githupsuser/SOS/HW/Common/ICS-40300.step

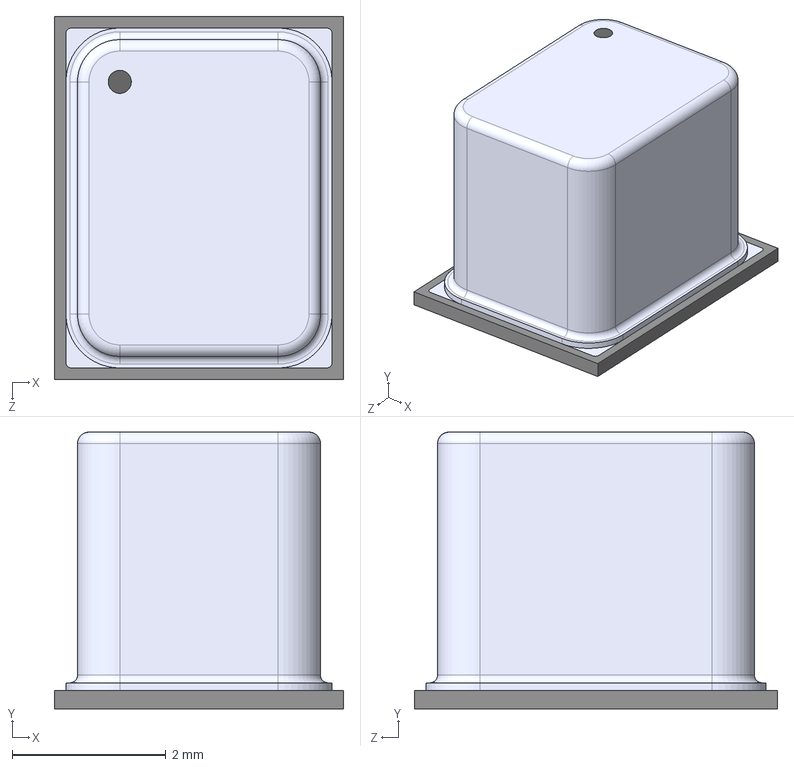
[picture p8: CAD file, 2024-11-08]
HW/Common/ICS-40300.step
3.76 x 3.60 x 4.72 mm
