githupsuser/SOS/HW/Common/STP_74930000 (rev1).stp

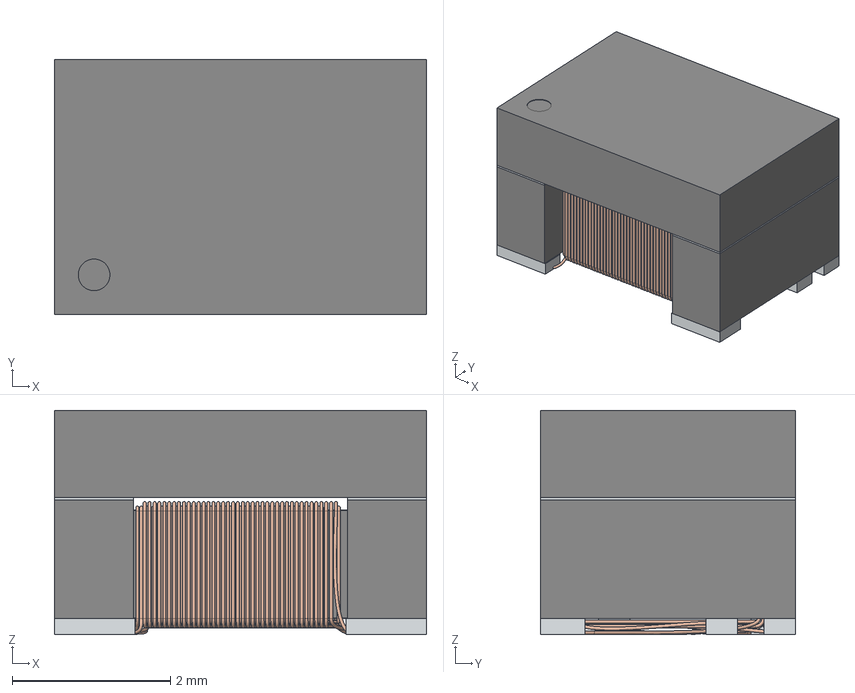
[picture p9: CAD file, 2024-11-08]
HW/Common/STP_74930000 (rev1).stp
4.70 x 3.22 x 2.83 mm
Core
Windings_02
Pins
Glue
Upper Plate
