githupsuser/SOS/HW/Main/SOS_Main.pdf

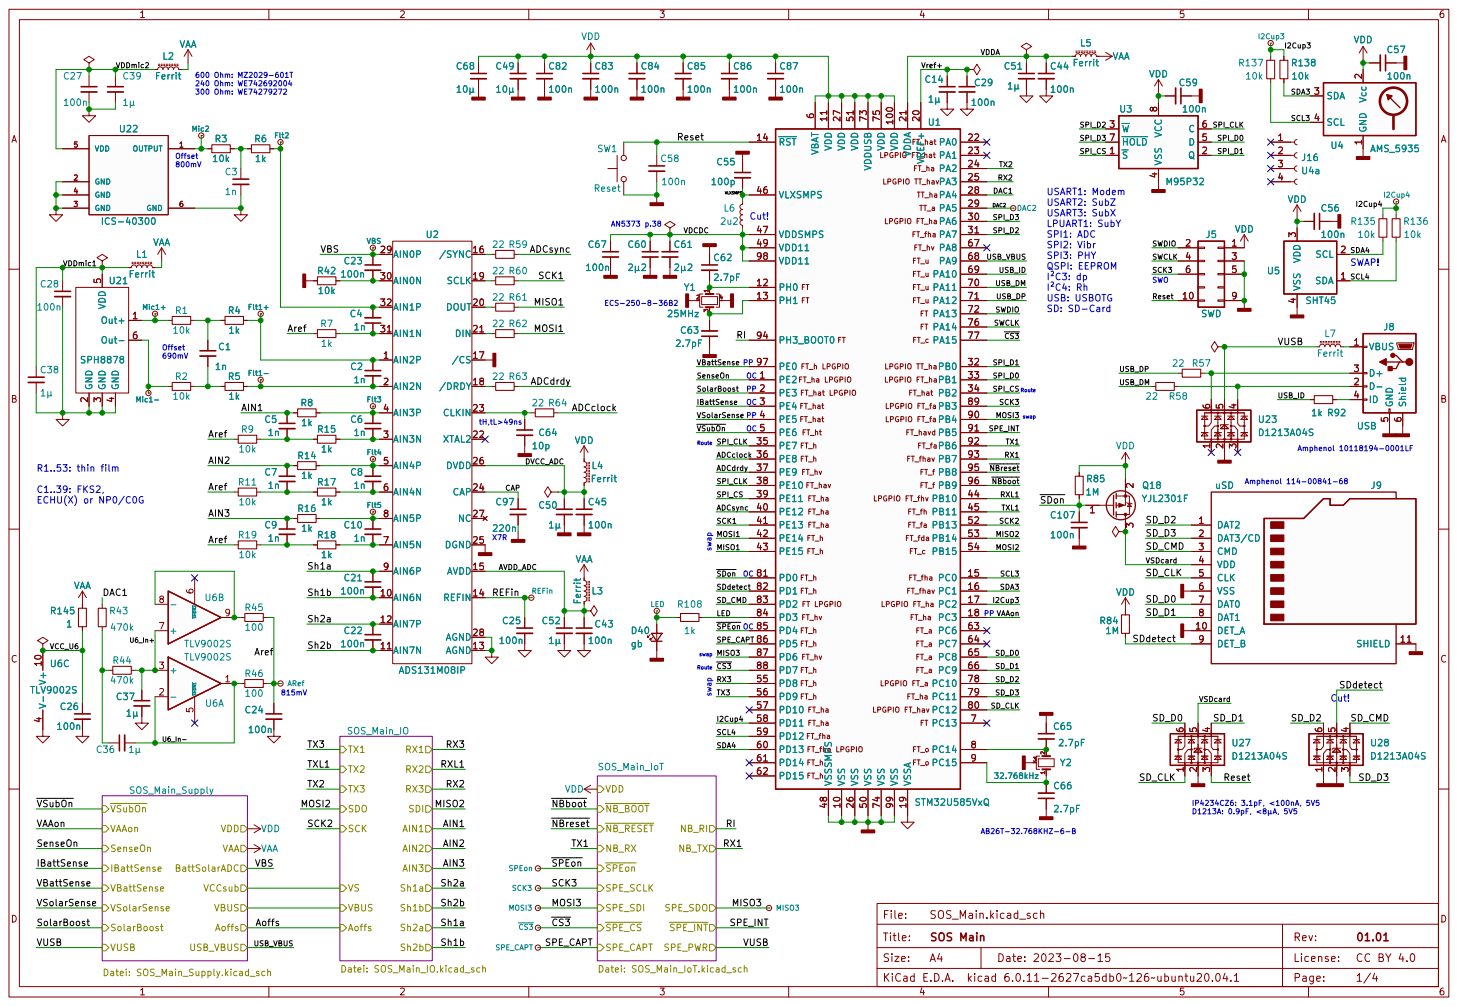
[picture p10: page 1]

1 Vcc 2 SDA 3 SCL 4 U4 AMS_5935 VDD

LPUART1: SubY
SPI1: ADC
SPI2: Vibr SPI3: PHY QSPI: EEPROM

þÿI²C4: Rh USB: USBOTG

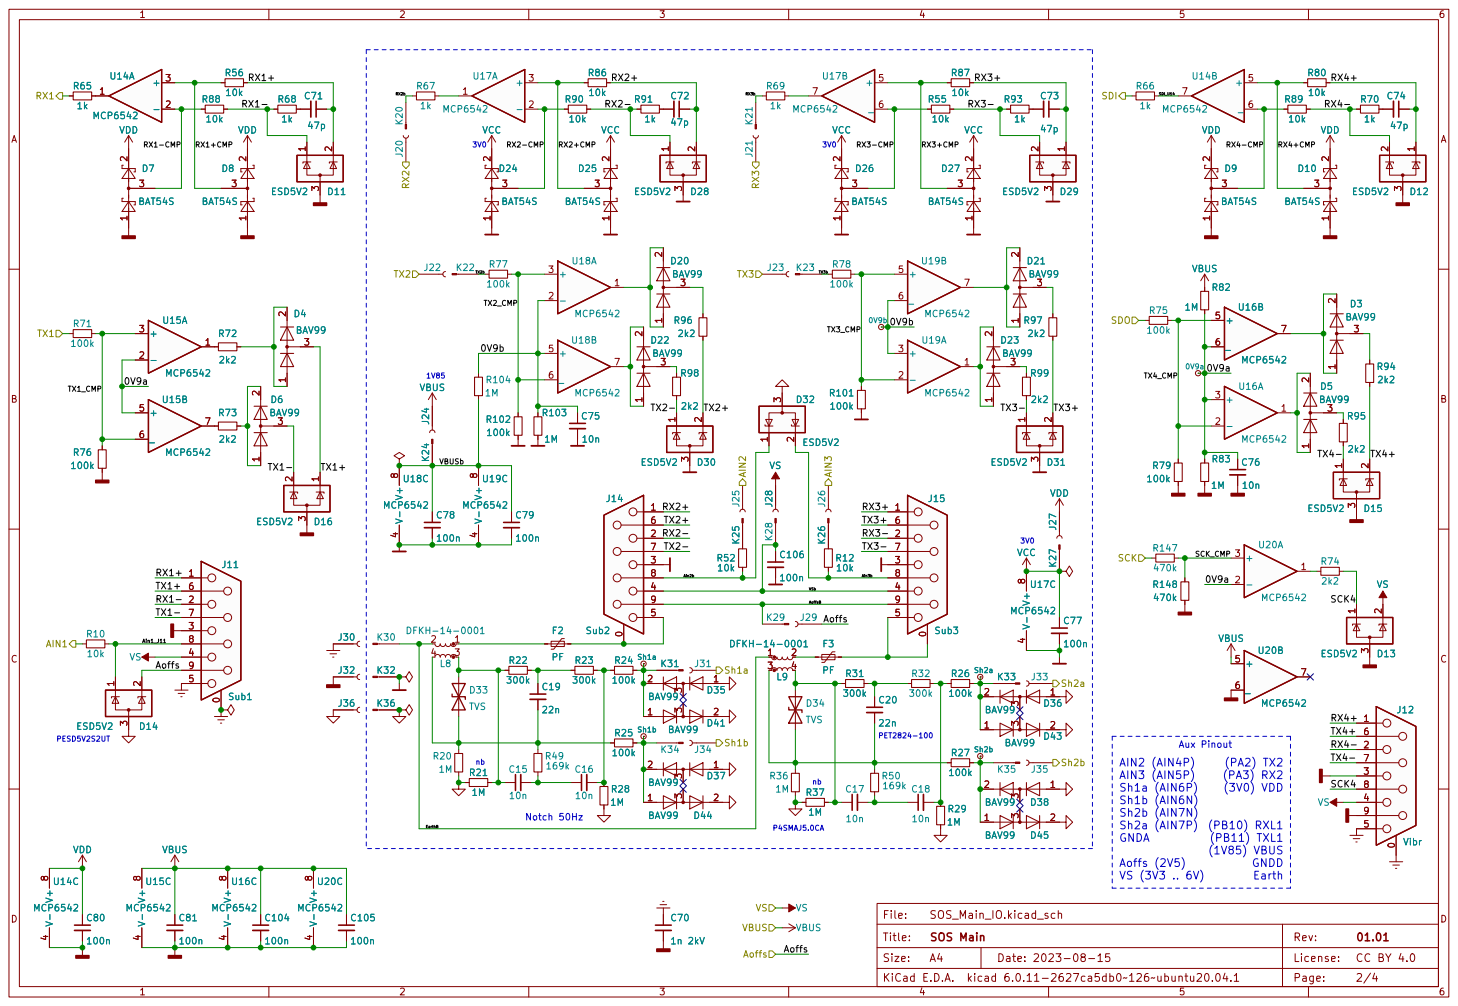
[picture p11: page 2]

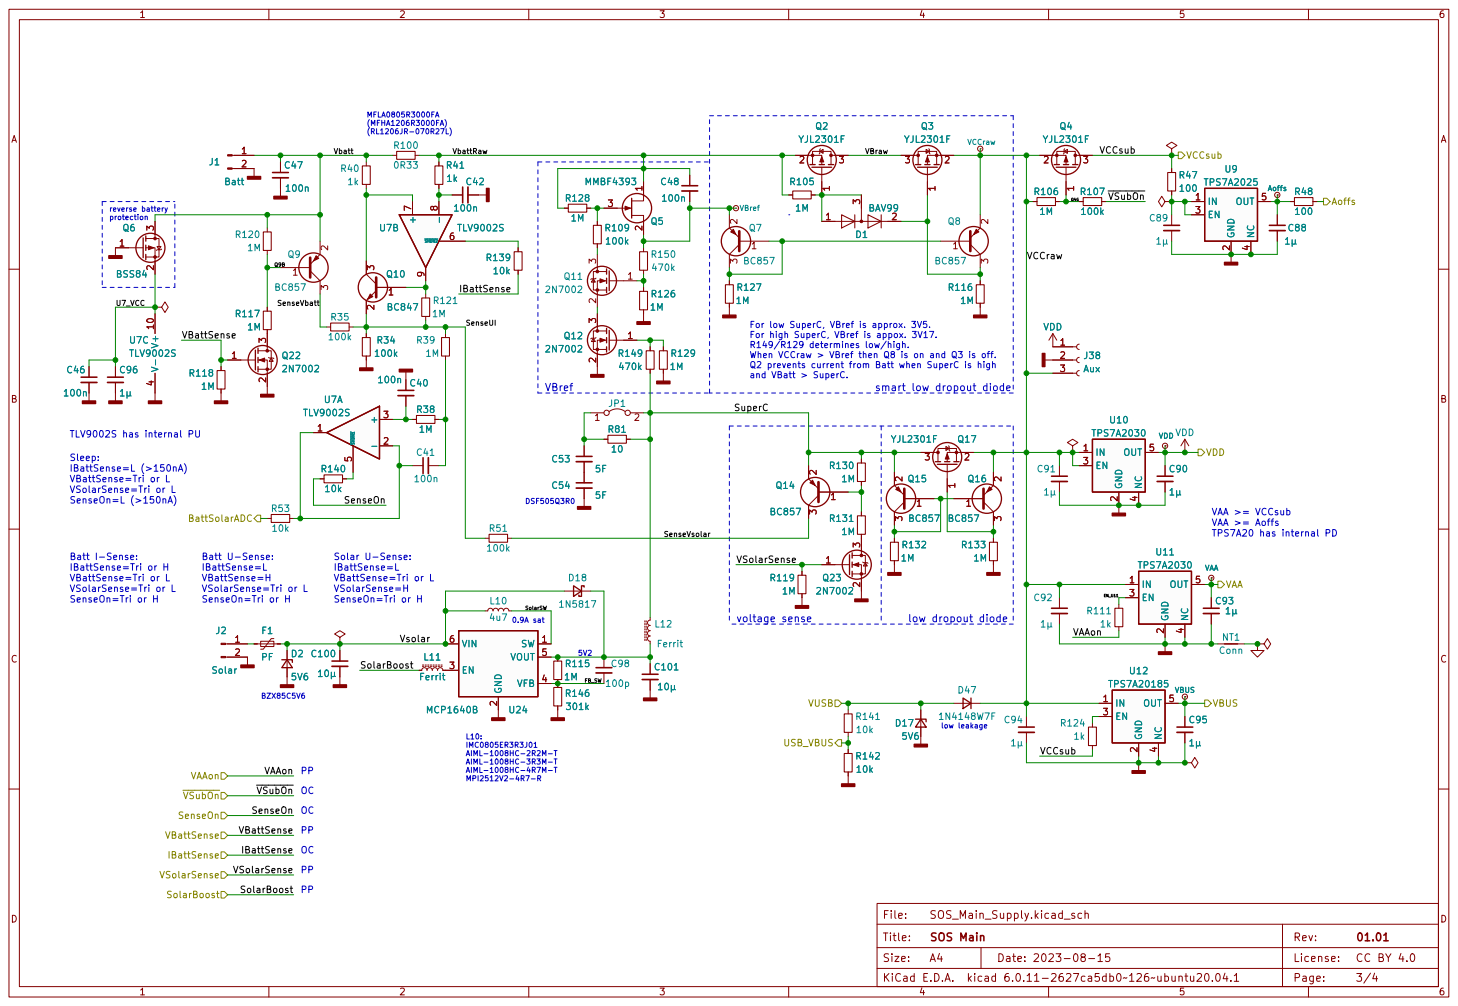
[picture p12: page 3]

SolarSW Vsolar SolarBoost VBattSense

voltage sense Batt I-Sense:

IBattSense VBattSense VAAon
SolarBoost VSolarSense SenseOn ~{VSubOn}

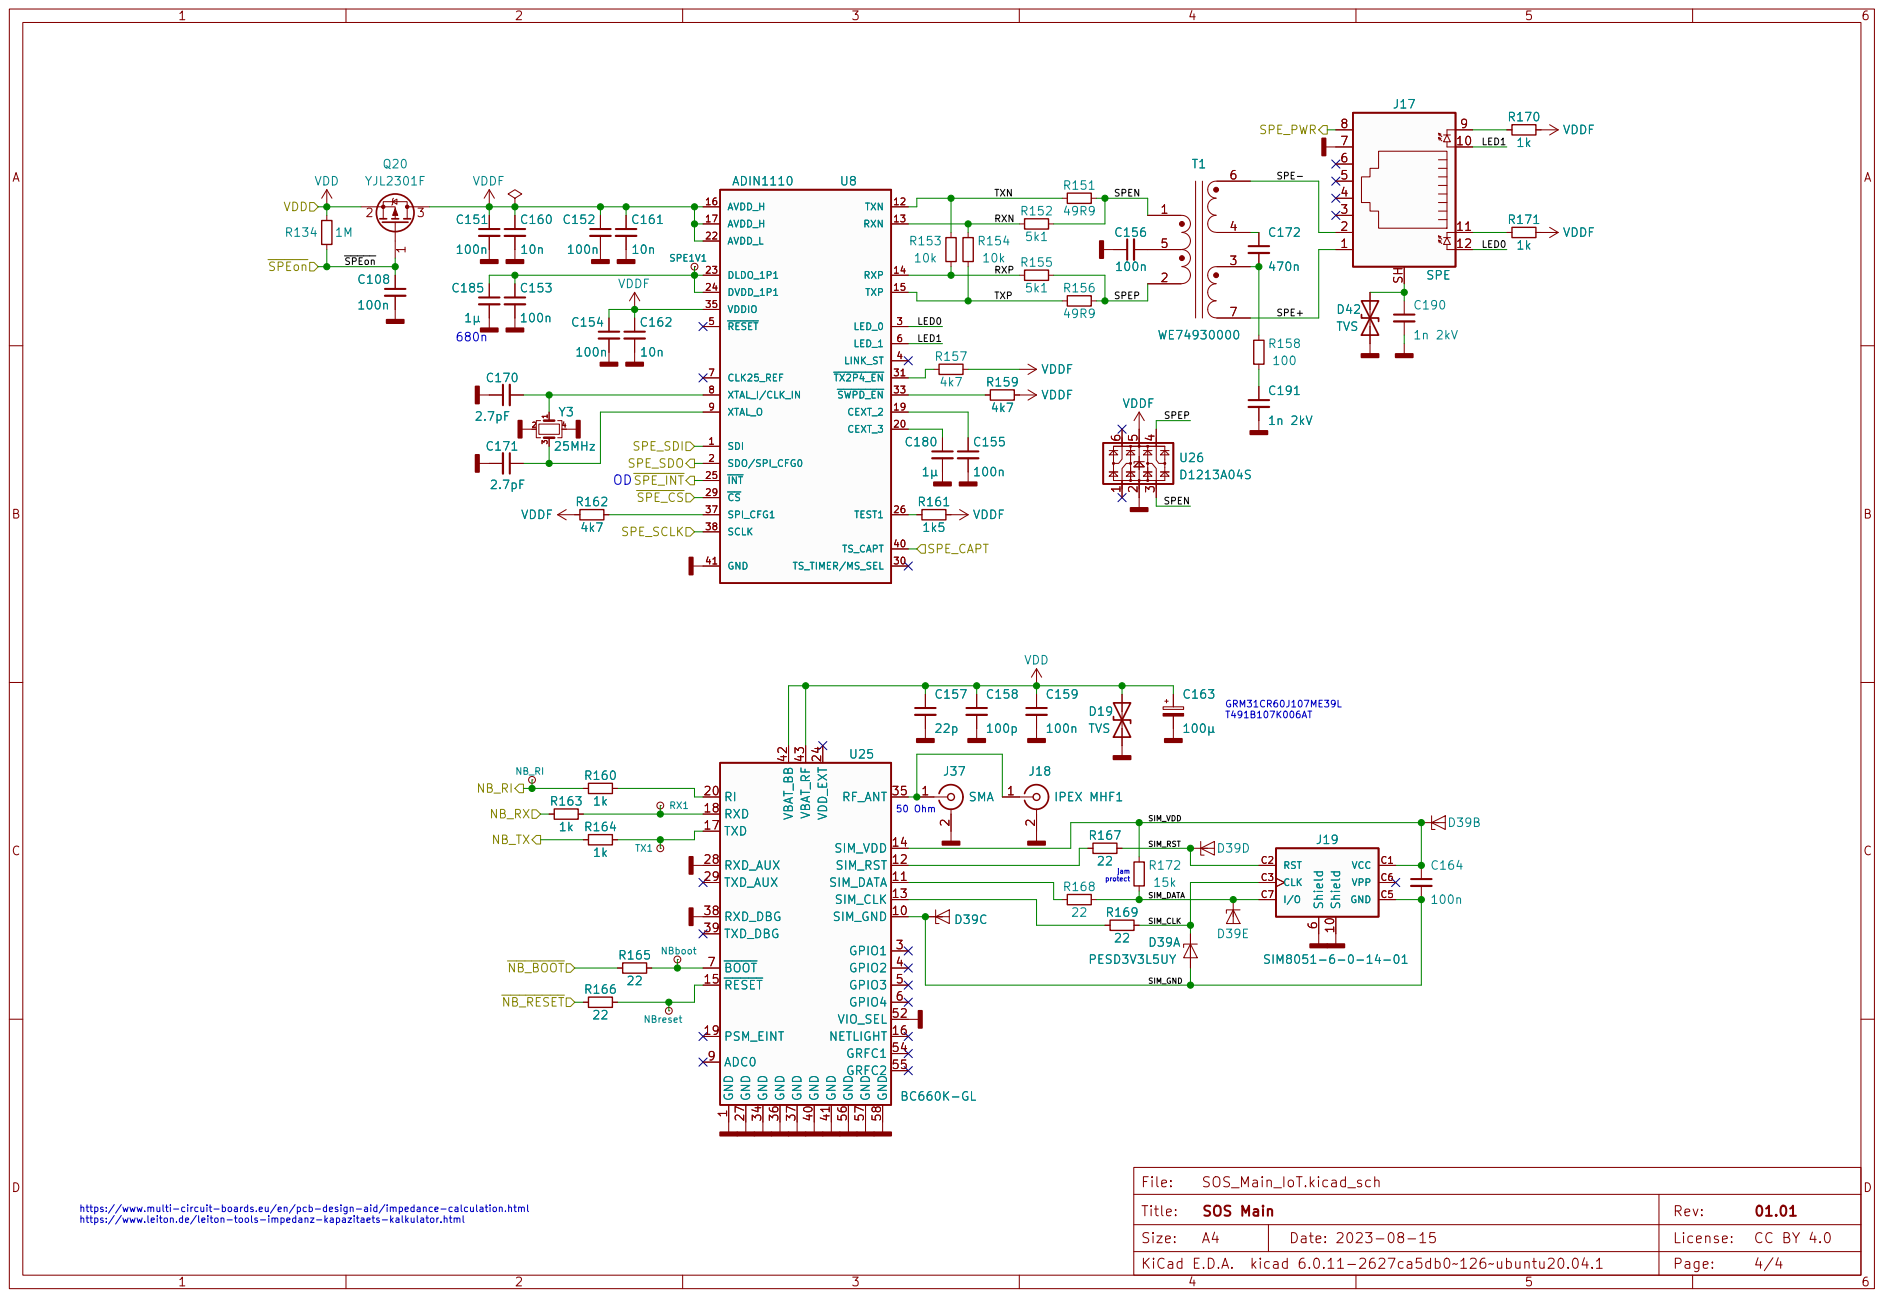
[picture p13: page 4]

https://www.multi-circuit-boards.eu/en/pcb-design-aid/impedance-calculation.html https://www.leiton.de/leiton-tools-impedanz-kapazitaets-kalkulator.html
