githupsuser/SOS/HW/Mic/SOS_Mic.pdf

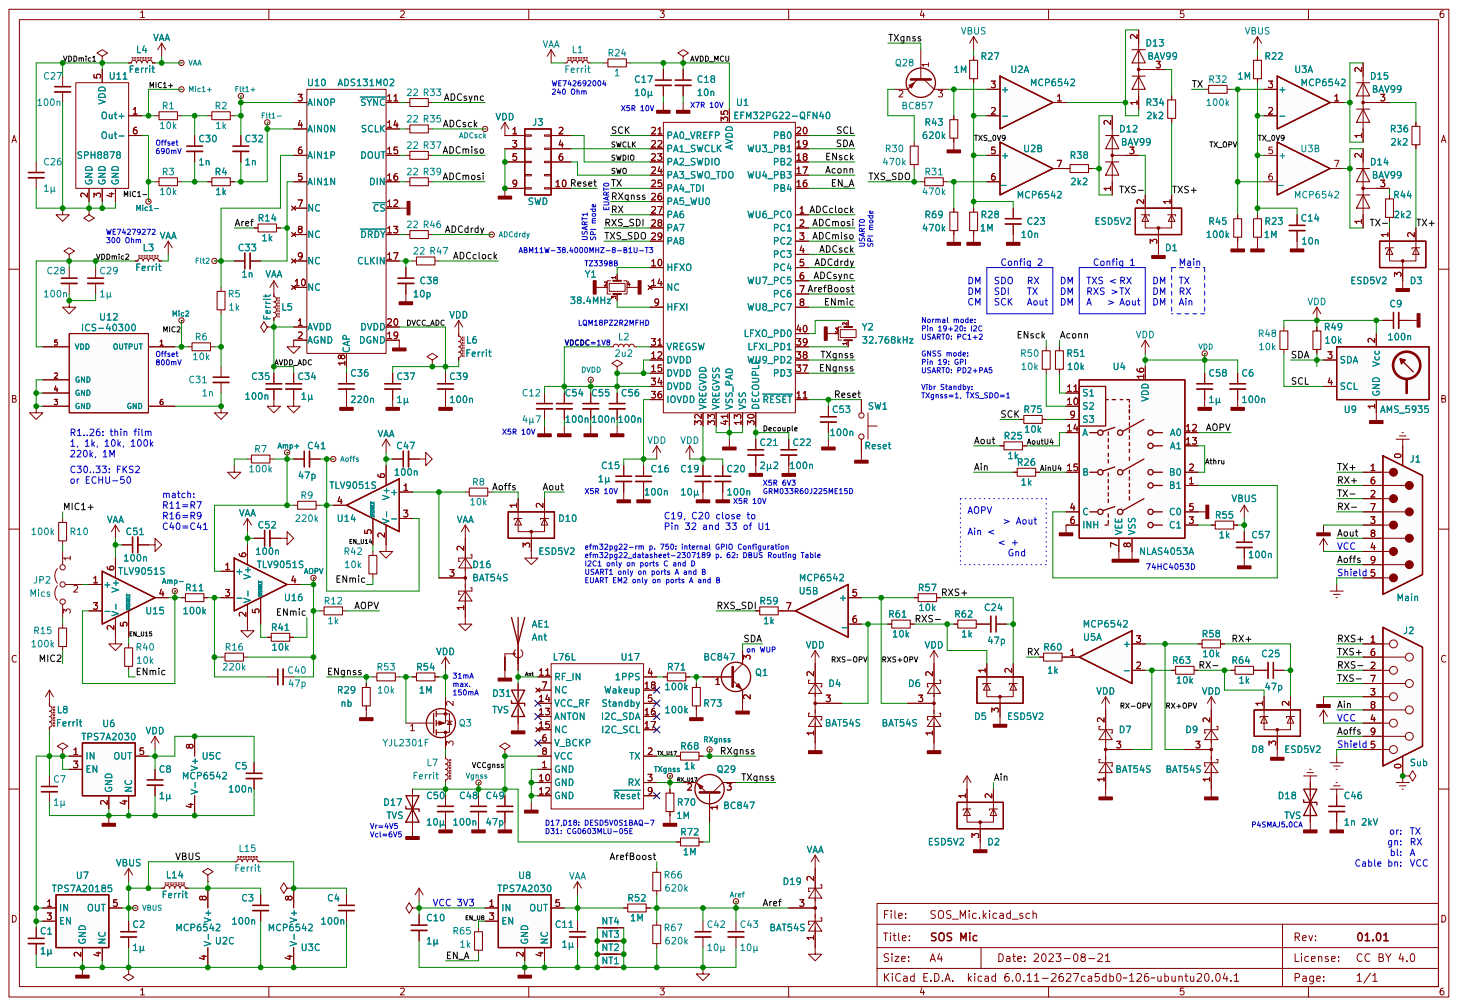
[picture p14: page 1]

I2C1 only on ports C and D
USART1 only on ports A and B

or: gn: bl: Cable bn:
