githupsuser/SOS/HW/Vibr/SOS_Vibr.pdf

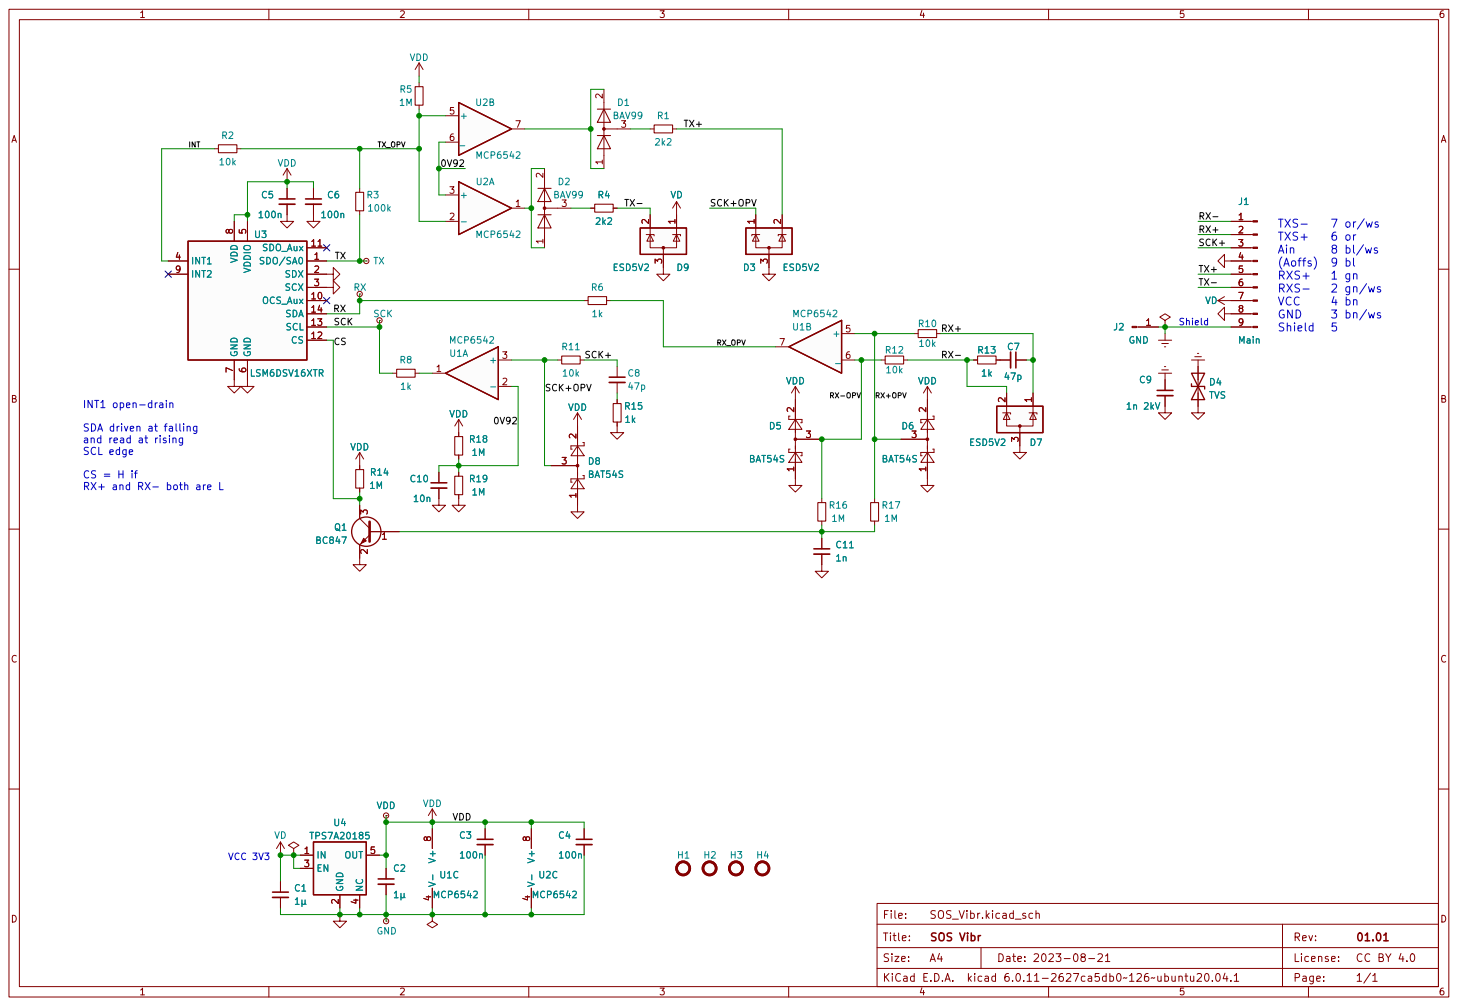
[picture p15: page 1]

INT1 open-drain SDA driven at falling
