githupsuser/SOS/HW/Vibr/SOS_Vibr.kicad_pcb

## KiCad design HW/Vibr/SOS_Vibr.kicad_pcb (2024-11-08)

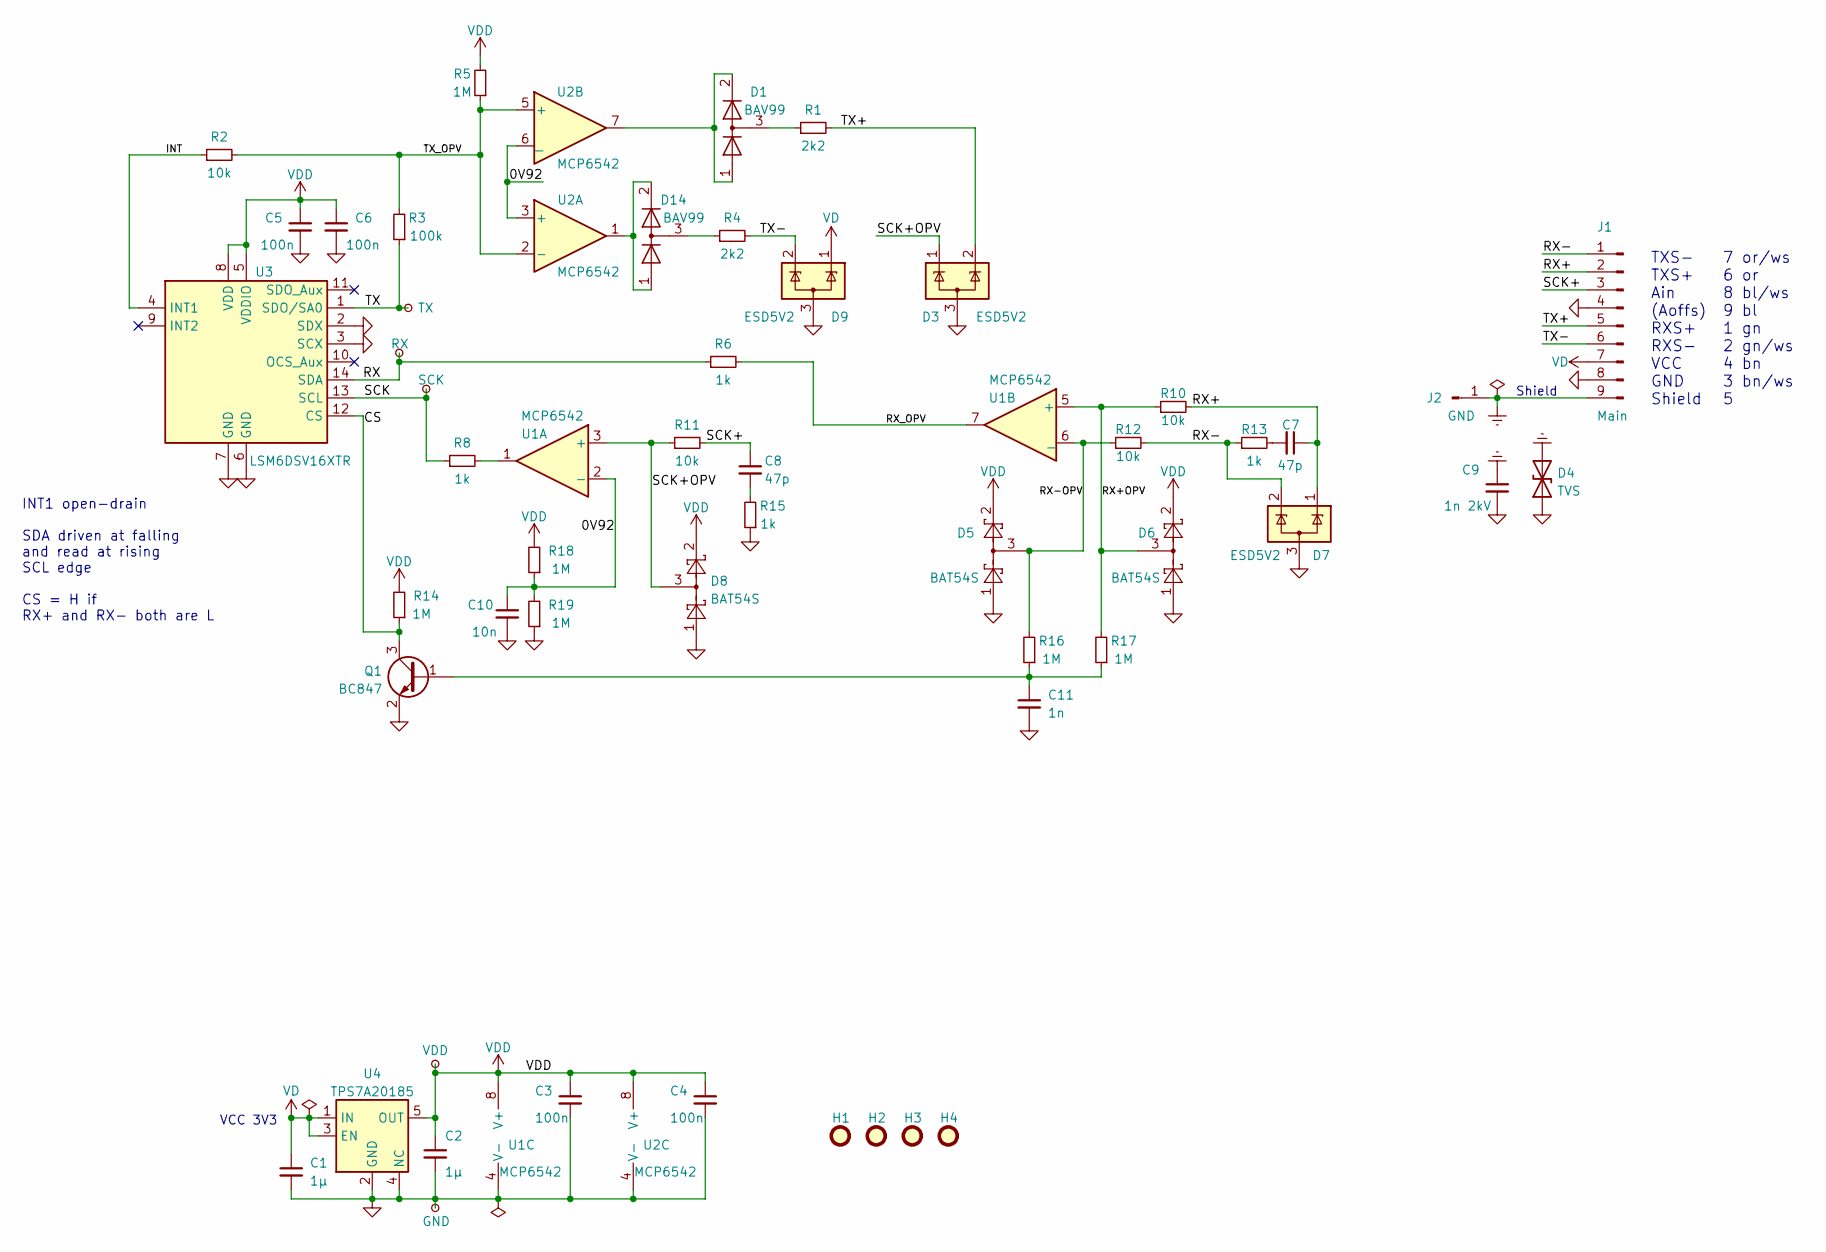
[picture p16: schematic SOS_Vibr.kicad_sch, SOS Vibr]

Parts:
C1, C2: 1µ; C_0805_2012Metric
C3, C4, C5, C6: 100n; C_0603_1608Metric
C7, C8: 47p; C_0603_1608Metric
C9: 1n 2kV; C_1206_3216Metric
C10: 10n; C_0603_1608Metric
C11: 1n; C_0603_1608Metric
D1, D14: BAV99; SOT-23
D3, D7, D9: ESD5V2; SOT-23
D4: TVS; D_SMA
D5, D6, D8: BAT54S; SOT-23
H1, H2, H3, H4: MountingHole; MountingHole_2.7mm_M2.5
J1: Main; PinHeader_1x09_P2.54mm_Vertical
J2: GND; SolderWire-0.75sqmm_1x01_D1.25mm_OD2.3mm
Q1: BC847; SOT-23
R1, R4: 2k2; R_0603_1608Metric
R2, R10, R11, R12: 10k; R_0603_1608Metric
R3: 100k; R_0603_1608Metric
R5, R14, R16, R17, R18, R19: 1M; R_0805_2012Metric
R6, R8, R13, R15: 1k; R_0603_1608Metric
TP1: VDD; TestPoint_THTPad_D1.0mm_Drill0.6mm
TP2: TX; TestPoint_THTPad_D1.0mm_Drill0.6mm
TP3: RX; TestPoint_THTPad_D1.0mm_Drill0.6mm
TP4: SCK; TestPoint_THTPad_D1.0mm_Drill0.6mm
TP5: GND; TestPoint_THTPad_D1.0mm_Drill0.6mm
U1, U2: MCP6542; SOIC-8_3.9x4.9mm_P1.27mm
U3: LSM6DSV16XTR; LGA-14_3x2.5mm_P0.5mm_LayoutBorder3x4y
U4: TPS7A20185; SOT-23-5

Connections:
/0V92: C10.1, R18.1, R19.2, U1.2 (-), U2.3 (+), U2.6 (_)
/CS: Q1.3 (C), R14.1, U3.12 (CS)
/INT: R2.1, U3.4 (INT1)
/RX: R6.1, TP3.1, U3.14 (SDA)
/RX+: C7.1, D7.1 (K), J1.2, R10.2
/RX+OPV: D6.3, R10.1, R17.2, U1.5 (+)
/RX-: D7.2 (K), J1.1, R12.2, R13.1
/RX-OPV: D5.3, R12.1, R16.2, U1.6 (_)
/RX_OPV: R6.2, U1.7
/SCK: R8.1, TP4.1, U3.13 (SCL)
/SCK+: C8.1, J1.3, R11.2
/SCK+OPV: D3.1 (K), D8.3, R11.1, U1.3 (+)
/TX: R3.1, TP2.1, U3.1 (SDO/SA0)
/TX+: D3.2 (K), J1.5, R1.2
/TX-: D9.2 (K), J1.6, R4.2
/TX_OPV: R2.2, R3.2, R5.1, U2.2 (-), U2.5 (+)
Earth: C9.1, D4.2 (A2), J1.9, J2.1
GNDA: C1.2, C2.2, C3.2, C4.2, C5.2, C6.2, C9.2, C10.2, C11.2, D3.3 (A), D4.1 (A1), D5.1, D6.1, D7.3 (A), D8.1, D9.3 (A), J1.4, J1.8, Q1.2 (E), R15.1, R19.1, TP5.1, U1.4 (V-), U2.4 (V-), U3.2 (SDX), U3.3 (SCX), U3.6 (GND), U3.7 (GND), U4.2 (GND), U4.4 (NC)
unnamed: C7.2, R13.2
unnamed: C8.2, R15.2
unnamed: C11.1, Q1.1 (B), R16.1, R17.1
unnamed: D1.1 (K), D1.2 (A), U2.7
unnamed: D1.3 (K), R1.1
unnamed: D14.1 (K), D14.2 (A), U2.1
unnamed: D14.3 (K), R4.1
unnamed: R8.2, U1.1
VD: C1.1, D9.1 (K), J1.7, U4.1 (IN), U4.3 (EN)
VDD: C2.1, C3.1, C4.1, C5.1, C6.1, D5.2, D6.2, D8.2, R5.2, R14.2, R18.2, TP1.1, U1.8 (V+), U2.8 (V+), U3.5 (VDDIO), U3.8 (VDD), U4.5 (OUT)

Notes on the sheet:
VCC 3V3
TXS- TXS+ Ain (Aoffs) RXS+ RXS- VCC GND Shield
7 or/ws 6 or 8 bl/ws 9 bl 1 gn 2 gn/ws 4 bn 3 bn/ws 5
INT1 open-drain SDA driven at falling and read at rising SCL edge CS = H if RX+ and RX- both are L
Shield

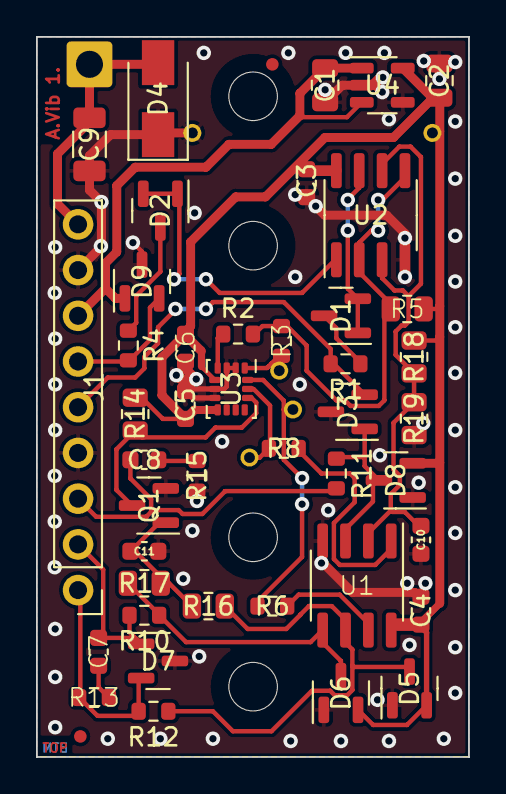
[picture p17: board SOS_Vibr.kicad_pcb from above]

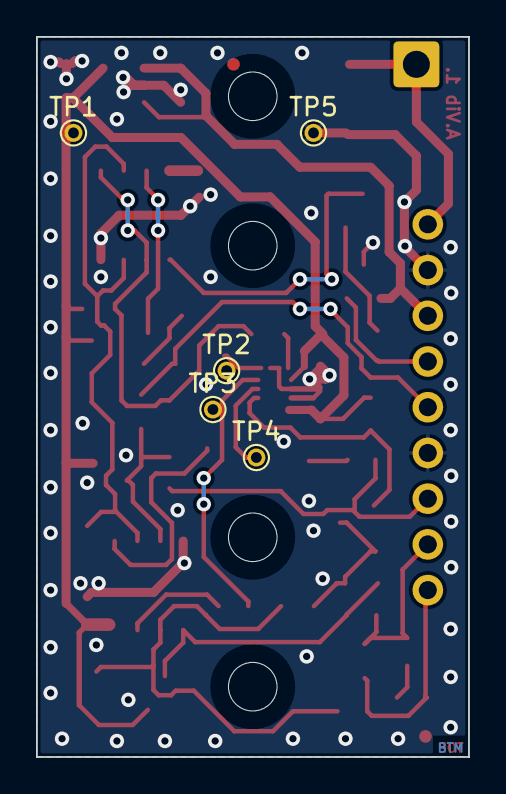
[picture p18: board SOS_Vibr.kicad_pcb from below]

Board: 2 copper layers, 24.0 x 40.0 mm, 53 parts (5 on the bottom side), 28 nets.
