githupsuser/SOS/HW/Mic/SOS_Mic.kicad_pcb

## KiCad design HW/Mic/SOS_Mic.kicad_pcb (2024-11-08)

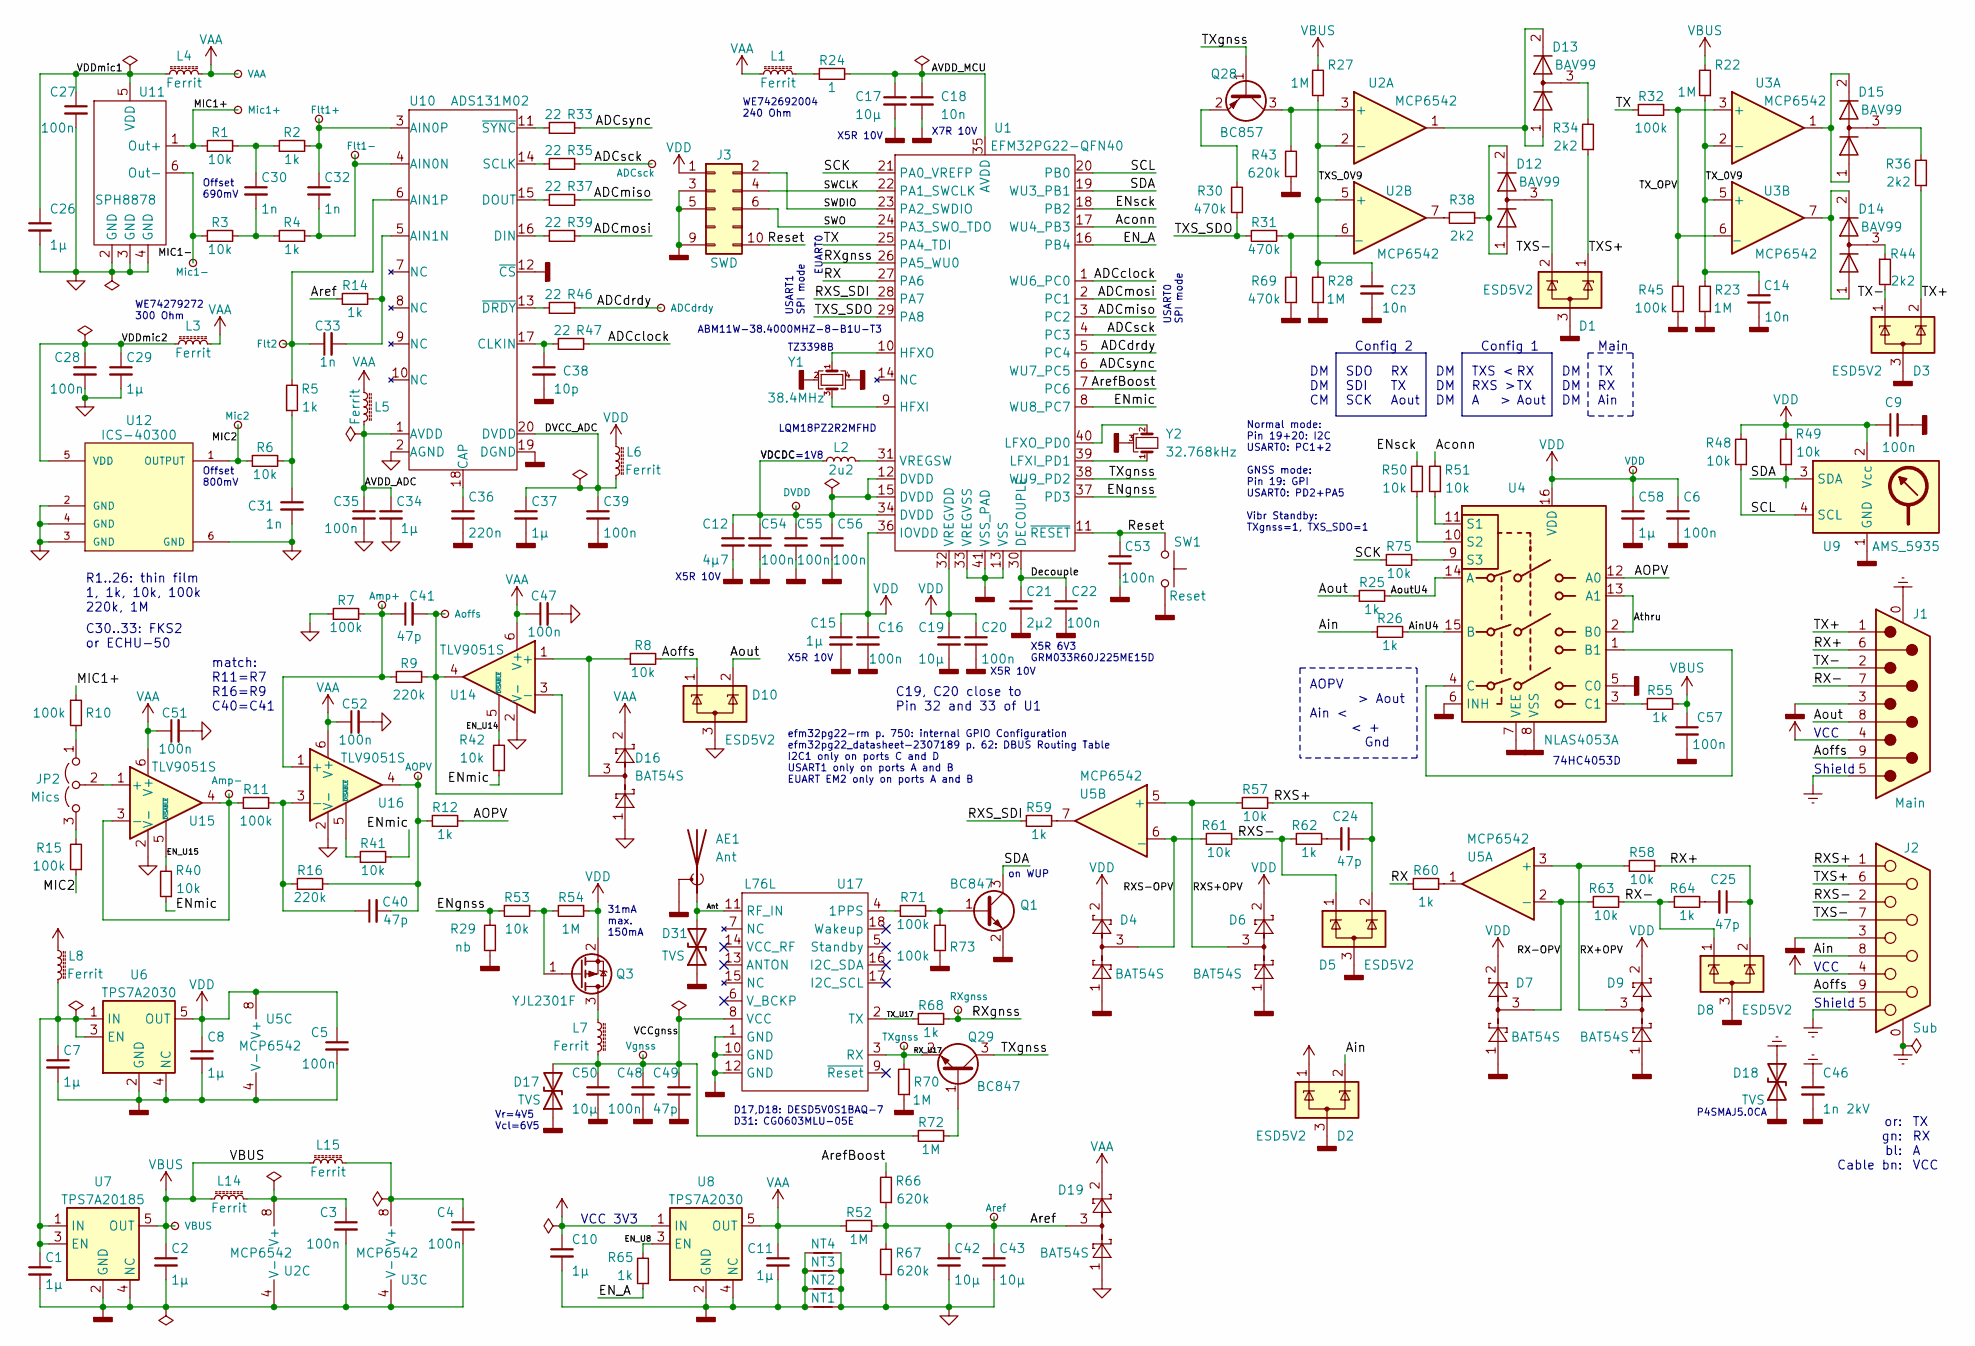
[picture p19: schematic SOS_Mic.kicad_sch, SOS Mic]

Parts:
AE1: Ant; IPEX_20279-001E-03
C1, C2, C7, C8, C10, C11, C15, C26, C29, C34, C37, C58: 1µ; C_0805_2012Metric
C3, C4, C5, C6, C9, C16, C20, C22, C27, C28, C35, C39, C47, C48, C51, C52, C53, C54, C55, C56, C57: 100n; C_0603_1608Metric
C12: 4µ7; C_0805_2012Metric
C14, C18, C23: 10n; C_0603_1608Metric
C17, C19, C42, C43, C50: 10µ; C_1206_3216Metric
C21: 2µ2; C_0805_2012Metric
C24, C25, C40, C41, C49: 47p; C_0603_1608Metric
C30, C31, C32, C33: 1n; C_0805_2012Metric
C36: 220n; C_0603_1608Metric
C38: 10p; C_0603_1608Metric
C46: 1n 2kV; C_1206_3216Metric
D1, D2, D3, D5, D8, D10: ESD5V2; SOT-23
D4, D6, D7, D9, D16, D19: BAT54S; SOT-23
D12, D13, D14, D15: BAV99; SOT-23
D17, D18: TVS; D_SMA
D31: TVS; D_0603_1608Metric
J1: Main; DSUB-9_Male_Horizontal_P2.77x2.84mm_EdgePinOffset7.70mm_Hou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
J2: Sub; DSUB-9_Female_Horizontal_P2.77x2.84mm_EdgePinOffset7.70mm_H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
J3: SWD; PinHeader_2x05_P1.27mm_Vertical
JP2: Mics; PinHeader_1x03_P2.54mm_Vertical
L1, L3, L4, L5, L6, L7, L8, L14, L15: Ferrit; L_0805_2012Metric
L2: 2u2; L_0805_2012Metric
NT1, NT2, NT3, NT4: Conn; Bridged2Bar_Pad1.0x1.5mm
Q1, Q29: BC847; SOT-23
Q3: YJL2301F; SOT-23-3
Q28: BC857; SOT-23
R1, R3, R6, R8, R40, R41, R42, R48, R49, R50, R51, R53, R57, R58, R61, R63, R75: 10k; R_0603_1608Metric
R2, R4, R5, R12, R14, R25, R26, R55, R59, R60, R62, R64, R65, R68: 1k; R_0603_1608Metric
R7, R10, R11, R15: 100k; R_0805_2012Metric
R9, R16: 220k; R_0805_2012Metric
R22, R23, R27, R28, R52, R54, R70, R72: 1M; R_0805_2012Metric
R24: 1; R_0805_2012Metric
R29: nb; R_0603_1608Metric
R30, R31, R69: 470k; R_0603_1608Metric
R32, R45, R71, R73: 100k; R_0603_1608Metric_Pad0.98x0.95mm_HandSolder
R33, R35, R37, R39, R46, R47: 22; R_0603_1608Metric
R34, R36, R38, R44: 2k2; R_0805_2012Metric
R43, R66, R67: 620k; R_0603_1608Metric
SW1: Reset; SW_Push_1P1T_NO_Vertical_Wuerth_434133025816
TP1: VBUS; TestPoint_THTPad_D1.0mm_Drill0.6mm
TP2: VDD; TestPoint_THTPad_D1.0mm_Drill0.6mm
TP3: DVDD; TestPoint_THTPad_D1.0mm_Drill0.6mm
TP4: Mic1-; TestPoint_THTPad_D1.0mm_Drill0.6mm
TP5: VAA; TestPoint_THTPad_D1.0mm_Drill0.6mm
TP6: Mic1+; TestPoint_THTPad_D1.0mm_Drill0.6mm
TP7: Mic2; TestPoint_THTPad_D1.0mm_Drill0.6mm
TP8: Flt2; TestPoint_THTPad_D1.0mm_Drill0.6mm
TP9: Flt1+; TestPoint_THTPad_D1.0mm_Drill0.6mm
TP10: Flt1-; TestPoint_THTPad_D1.0mm_Drill0.6mm
TP11: Amp+; TestPoint_THTPad_D1.0mm_Drill0.6mm
TP12: Aoffs; TestPoint_THTPad_D1.0mm_Drill0.6mm
TP14: Aref; TestPoint_THTPad_D1.0mm_Drill0.6mm
TP15: Amp-; TestPoint_THTPad_D1.0mm_Drill0.6mm
TP16: AOPV; TestPoint_THTPad_D1.0mm_Drill0.6mm
TP18: Vgnss; TestPoint_THTPad_D1.0mm_Drill0.6mm
TP19: ADCsck; TestPoint_THTPad_D1.0mm_Drill0.6mm
TP20: ADCdrdy; TestPoint_THTPad_D1.0mm_Drill0.6mm
TP21: RXgnss; TestPoint_THTPad_D1.0mm_Drill0.6mm
TP22: TXgnss; TestPoint_THTPad_D1.0mm_Drill0.6mm
U1: EFM32PG22-QFN40; QFN-40-1EP_5x5mm_P0.4mm_EP3.8x3.8mm
U2, U3, U5: MCP6542; SOIC-8_3.9x4.9mm_P1.27mm
U4: NLAS4053A; SOIC-16_3.9x9.9mm_P1.27mm
U6, U8: TPS7A2030; SOT-23-5
U7: TPS7A20185; SOT-23-5
U9: AMS_5935; DIP-8_W7.62mm_L15.25mm
U10: ADS131M02; TSSOP-20_4.4x6.5mm_P0.65mm
U11: SPH8878; Knowles_LGA-6_3.5x2.65mm
U12: ICS-40300; MIC_ICS-40300
U14, U15, U16: TLV9051S; SOT-23-6
U17: L76L; XCVR_L76-L
Y1: 38.4MHz; Crystal_SMD_2520-4Pin_2.5x2.0mm
Y2: 32.768kHz; Crystal_C26-LF_D2.1mm_L6.5mm_Horizontal_1EP_style1

Connections:
/ADCclock: R47.2, U1.1 (WU6_PC0)
/ADCdrdy: R46.2, TP20.1, U1.5 (PC4)
/ADCmiso: R37.2, U1.3 (PC2)
/ADCmosi: R39.2, U1.2 (PC1)
/ADCsck: R35.2, TP19.1, U1.4 (PC3)
/ADCsync: R33.2, U1.6 (WU7_PC5)
/AOPV: R12.2, U4.12 (A0)
/AVDD_ADC: C34.1, C35.1, L5.2, U10.1 (AVDD)
/AVDD_MCU: C17.1, C18.1, R24.2, U1.35 (AVDD)
/Aconn: R51.2, U1.17 (WU4_PB3)
/Ain: D2.2 (K), J2.8, R26.1
/AinU4: R26.2, U4.15 (B)
/Ant: AE1.1 (A), D31.2 (A2), U17.11 (RF_IN)
/Aoffs: D10.1 (K), J1.9, J2.9, R8.2
/Aout: D10.2 (K), J1.8, R25.1
/AoutU4: R25.2, U4.14 (A)
/Aref: C42.1, C43.1, D19.3, R14.1, R52.2, R66.1, R67.2, TP14.1
/ArefBoost: R66.2, U1.7 (PC6)
/Athru: U4.2 (B0), U4.13 (A1)
/DVCC_ADC: C37.1, C39.1, L6.2, U10.20 (DVDD)
/Decouple: C21.1, C22.1, U1.30 (DECOUPLE)
/EN_A: R65.1, U1.16 (PB4)
/EN_U8: R65.2, U8.3 (EN)
/EN_U14: R42.2, U14.5 (~DISABLE)
/EN_U15: R40.2, U15.5 (~DISABLE)
/ENgnss: R29.2, R53.2, U1.37 (PD3)
/ENmic: R40.1, R41.2, R42.1, U1.8 (WU8_PC7)
/ENsck: R50.2, U1.18 (PB2)
/MIC1+: R1.1, R10.1, TP6.1, U11.1 (Out+)
/MIC1-: R3.1, TP4.1, U11.6 (Out-)
/MIC2: R6.1, R15.1, TP7.1, U12.1 (OUTPUT)
/RX: R60.1, U1.27 (PA6)
/RX+: C25.1, D8.2 (K), J1.6, R58.2
/RX+OPV: D9.3, R58.1, U5.3 (+)
/RX-: D8.1 (K), J1.7, R63.2, R64.1
/RX-OPV: D7.3, R63.1, U5.2 (-)
/RXS+: C24.1, D5.2 (K), J2.1, R57.2
/RXS+OPV: D6.3, R57.1, U5.5 (+)
/RXS-: D5.1 (K), J2.2, R61.2, R62.1
/RXS-OPV: D4.3, R61.1, U5.6 (_)
/RXS_SDI: R59.1, U1.28 (PA7)
/RX_U17: Q29.2 (E), R70.2, TP22.1, U17.3 (RX)
/RXgnss: R68.2, TP21.1, U1.26 (PA5_WU0)
/Reset: C53.1, J3.10, SW1.2, U1.11 (~RESET)
/SCK: R75.1, U1.21 (PA0_VREFP)
/SCL: R48.1, U1.20 (PB0), U9.4 (SCL)
/SDA: Q1.3 (C), R49.1, U1.19 (WU3_PB1), U9.3 (SDA)
/SWCLK: J3.4, U1.22 (PA1_SWCLK)
/SWDIO: J3.2, U1.23 (PA2_SWDIO)
/SWO: J3.6, U1.24 (PA3_SWO_TDO)
/TX: R32.1, U1.25 (PA4_TDI)
/TX+: D3.2 (K), J1.1, R36.1
/TX-: D3.1 (K), J1.2, R44.2
/TXS+: D1.1 (K), J2.6, R34.1
/TXS-: D1.2 (K), D12.3 (K), J2.7
/TXS_0V9: C23.1, R27.1, R28.2, U2.2 (-), U2.5 (+)
/TXS_SDO: R30.1, R31.2, U1.29 (PA8)
/TX_0V9: C14.1, R22.1, R23.2, U3.2 (-), U3.5 (+)
/TX_OPV: R32.2, R45.2, U3.3 (+), U3.6 (_)
/TX_U17: R68.1, U17.2 (TX)
/TXgnss: Q28.1 (B), Q29.3 (C), U1.38 (WU9_PD2)
/VCCgnss: C48.1, C49.1, C50.1, D17.2 (A2), L7.2, R72.1, TP18.1, U17.8 (VCC)
/VDCDC: C12.1, C54.1, C55.1, C56.1, L2.1, TP3.1, U1.12 (DVDD), U1.15 (DVDD), U1.34 (DVDD)
/VDDmic1: C26.1, C27.1, L4.1, U11.5 (VDD)
/VDDmic2: C28.1, C29.1, L3.1, U12.5 (VDD)
Earth: C46.1, D18.2 (A2), J1.0 (PAD), J1.5, J2.0 (PAD), J2.5
GNDA: C26.2, C27.2, C28.2, C29.2, C31.2, C34.2, C35.2, C42.2, C43.2, C47.2, C51.2, C52.2, D10.3 (A), D16.1, D19.1, NT1.1, NT2.1, NT3.1, NT4.1, R7.1, R67.1, U10.2 (AGND), U11.2 (GND), U11.3 (GND), U11.4 (GND), U12.2 (GND), U12.3 (GND), U12.4 (GND), U12.6 (GND), U14.2 (V-), U15.2 (V-), U16.2 (V-)
GNDD: AE1.2 (Shield), AE1.3 (Shield), C1.2, C2.2, C3.2, C4.2, C5.2, C6.2, C7.2, C8.2, C9.2, C10.2, C11.2, C12.2, C14.2, C15.2, C16.2, C17.2, C18.2, C19.2, C20.2, C21.2, C22.2, C23.2, C36.2, C37.2, C38.2, C39.2, C46.2, C48.2, C49.2, C50.2, C53.2, C54.2, C55.2, C56.2, C57.2, C58.2, D1.3 (A), D2.3 (A), D3.3 (A), D4.1, D5.3 (A), D6.1, D7.1, D8.3 (A), D9.1, D17.1 (A1), D18.1 (A1), D31.1 (A1), J1.3, J2.3, J3.3, J3.5, J3.9, NT1.2, NT2.2, NT3.2, NT4.2, Q1.2 (E), R23.1, R28.1, R29.1, R43.1, R45.1, R69.1, R70.1, R73.1, SW1.1, U1.13 (VSS), U1.33 (VREGVSS), U1.41 (VSS_PAD), U2.4 (V-), U3.4 (V-), U4.5 (C0), U4.6 (INH), U4.7 (VEE), U4.8 (VSS), U5.4 (V-), U6.2 (GND), U6.4 (NC), U7.2 (GND), U7.4 (NC), U8.2 (GND), U8.4 (NC), U9.1 (GND), U10.12 (~CS), U10.19 (DGND), U17.1 (GND), U17.10 (GND), U17.12 (GND), Y1.2, Y1.4, Y2.3
unnamed: C1.1, C7.1, L8.2, U6.1 (IN), U6.3 (EN), U7.1 (IN), U7.3 (EN)
unnamed: C3.1, L14.2, U2.8 (V+)
unnamed: C4.1, L15.2, U3.8 (V+)
unnamed: C24.2, R62.2
unnamed: C25.2, R64.2
unnamed: C30.1, R1.2, R2.1
unnamed: C30.2, R3.2, R4.1
unnamed: C31.1, R5.1, R6.2
unnamed: C32.1, R2.2, TP9.1, U10.3 (AIN0P)
unnamed: C32.2, R4.2, TP10.1, U10.4 (AIN0N)
unnamed: C33.1, R5.2, TP8.1, U10.6 (AIN1P)
unnamed: C33.2, R14.2, U10.5 (AIN1N)
unnamed: C36.1, U10.18 (CAP)
unnamed: C38.1, R47.1, U10.17 (CLKIN)
unnamed: C40.1, R11.2, R16.1, U16.3 (-)
unnamed: C40.2, R12.1, R16.2, TP16.1, U16.4
unnamed: C41.1, R7.2, R9.1, TP11.1, U16.1 (+)
unnamed: C41.2, R9.2, TP12.1, U14.3 (-), U14.4
unnamed: D12.1 (K), D12.2 (A), R38.1
unnamed: D13.1 (K), D13.2 (A), U2.1
unnamed: D13.3 (K), R34.2
unnamed: D14.1 (K), D14.2 (A), U3.7
unnamed: D14.3 (K), R44.1
unnamed: D15.1 (K), D15.2 (A), U3.1
unnamed: D15.3 (K), R36.2
unnamed: D16.3, R8.1, U14.1 (+)
unnamed: JP2.1 (A), R10.2
unnamed: JP2.2 (C), U15.1 (+)
unnamed: JP2.3 (B), R15.2
unnamed: L1.2, R24.1
unnamed: L2.2, U1.31 (VREGSW)
unnamed: L7.1, Q3.3 (D)
unnamed: Q1.1 (B), R71.2, R73.2
unnamed: Q3.1 (G), R53.1, R54.2
unnamed: Q28.2 (E), R30.2
unnamed: Q28.3 (C), R43.2, U2.3 (+)
unnamed: Q29.1 (B), R72.2
unnamed: R11.1, TP15.1, U15.3 (-), U15.4
unnamed: R31.1, R69.2, U2.6 (_)
unnamed: R33.1, U10.11 (~SYNC)
unnamed: R35.1, U10.14 (SCLK)
unnamed: R37.1, U10.15 (DOUT)
unnamed: R38.2, U2.7
unnamed: R39.1, U10.16 (DIN)
unnamed: R41.1, U16.5 (~DISABLE)
unnamed: R46.1, U10.13 (~DRDY)
unnamed: R50.1, U4.10 (S2)
unnamed: R51.1, U4.11 (S1)
unnamed: R55.1, U4.3 (C1)
unnamed: R59.2, U5.7
unnamed: R60.2, U5.1
unnamed: R71.1, U17.4 (1PPS)
unnamed: R75.2, U4.9 (S3)
unnamed: U1.9 (HFXI), Y1.3
unnamed: U1.10 (HFXO), Y1.1
unnamed: U1.39 (LFXI_PD1), Y2.1
unnamed: U1.40 (LFXO_PD0), Y2.2
unnamed: U4.1 (B1), U4.4 (C)
VAA: C11.1, C47.1, C51.1, C52.1, D16.2, D19.2, L1.1, L3.2, L4.2, L5.1, R52.1, TP5.1, U8.5 (OUT), U14.6 (V+), U15.6 (V+), U16.6 (V+)
VBUS: C2.1, C57.1, L14.1, L15.1, R22.2, R27.2, R55.2, TP1.1, U7.5 (OUT)
VDD: C5.1, C6.1, C8.1, C9.1, C15.1, C16.1, C19.1, C20.1, C58.1, D4.2, D6.2, D7.2, D9.2, J3.1, L6.1, Q3.2 (S), R48.2, R49.2, R54.1, TP2.1, U1.32 (VREGVDD), U1.36 (IOVDD), U4.16 (VDD), U5.8 (V+), U6.5 (OUT), U9.2 (Vcc)
VDDA: C10.1, D2.1 (K), J1.4, J2.4, L8.1, U8.1 (IN)

Notes on the sheet:
VCC
X5R 10V
C19, C20 close to Pin 32 and 33 of U1
Shield
VCC 3V3
EUART0
D17,D18: DESD5V0S1BAQ-7 D31: CG0603MLU-05E
SDO SDI SCK
DM DM DM
RX TX Aout
X7R 10V
31mA max. 150mA
match: R11=R7 R16=R9 C40=C41
R1..26: thin film 1, 1k, 10k, 100k 220k, 1M
efm32pg22-rm p. 750: internal GPIO Configuration efm32pg22_datasheet-2307189 p. 62: DBUS Routing Table I2C1 only on ports C and D USART1 only on ports A and B EUART EM2 only on ports A and B
DM DM CM
ABM11W-38.4000MHZ-8-B1U-T3
Vr=4V5 Vcl=6V5
TX RX Ain
AOPV > Aout Ain < < + Gnd
WE74279272 300 Ohm
Config 1
TX RX A VCC
Main
74HC4053D
on WUP
P4SMAJ5.0CA
Normal mode: Pin 19+20: I2C USART0: PC1+2 GNSS mode: Pin 19: GPI USART0: PD2+PA5 Vibr Standby: TXgnss=1, TXS_SDO=1
C30..33: FKS2 or ECHU-50
WE742692004 240 Ohm
X5R 6V3 GRM033R60J225ME15D
USART0 SPI mode
Offset 690mV
TZ3398B
TXS < RXS > A >
Config 2
Offset 800mV
USART1 SPI mode
LQM18PZ2R2MFHD
or: gn: bl: Cable bn:
VDCDC=1V8

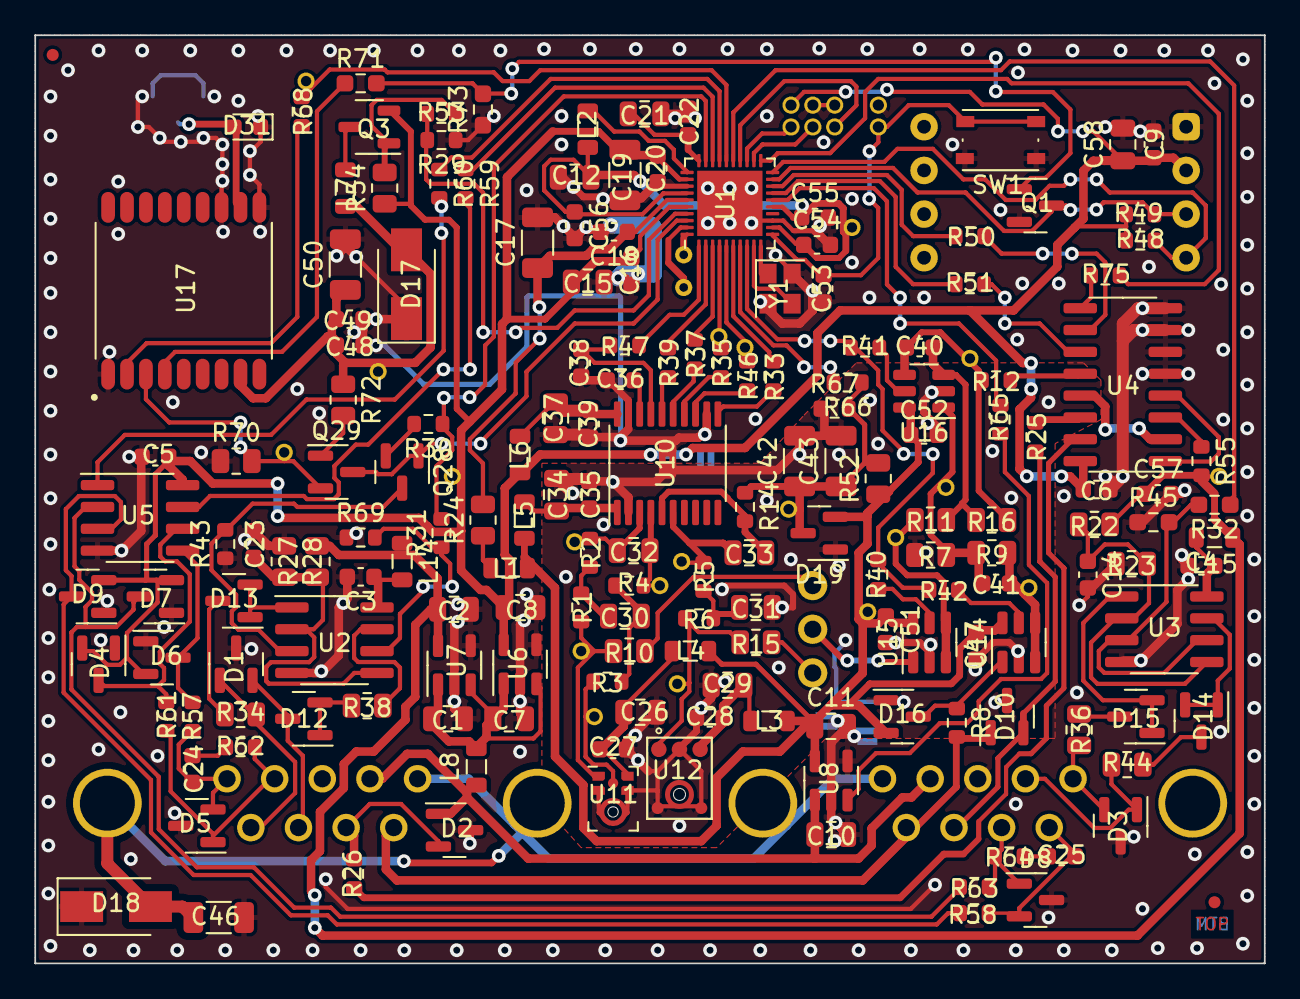
[picture p20: board SOS_Mic.kicad_pcb from above]

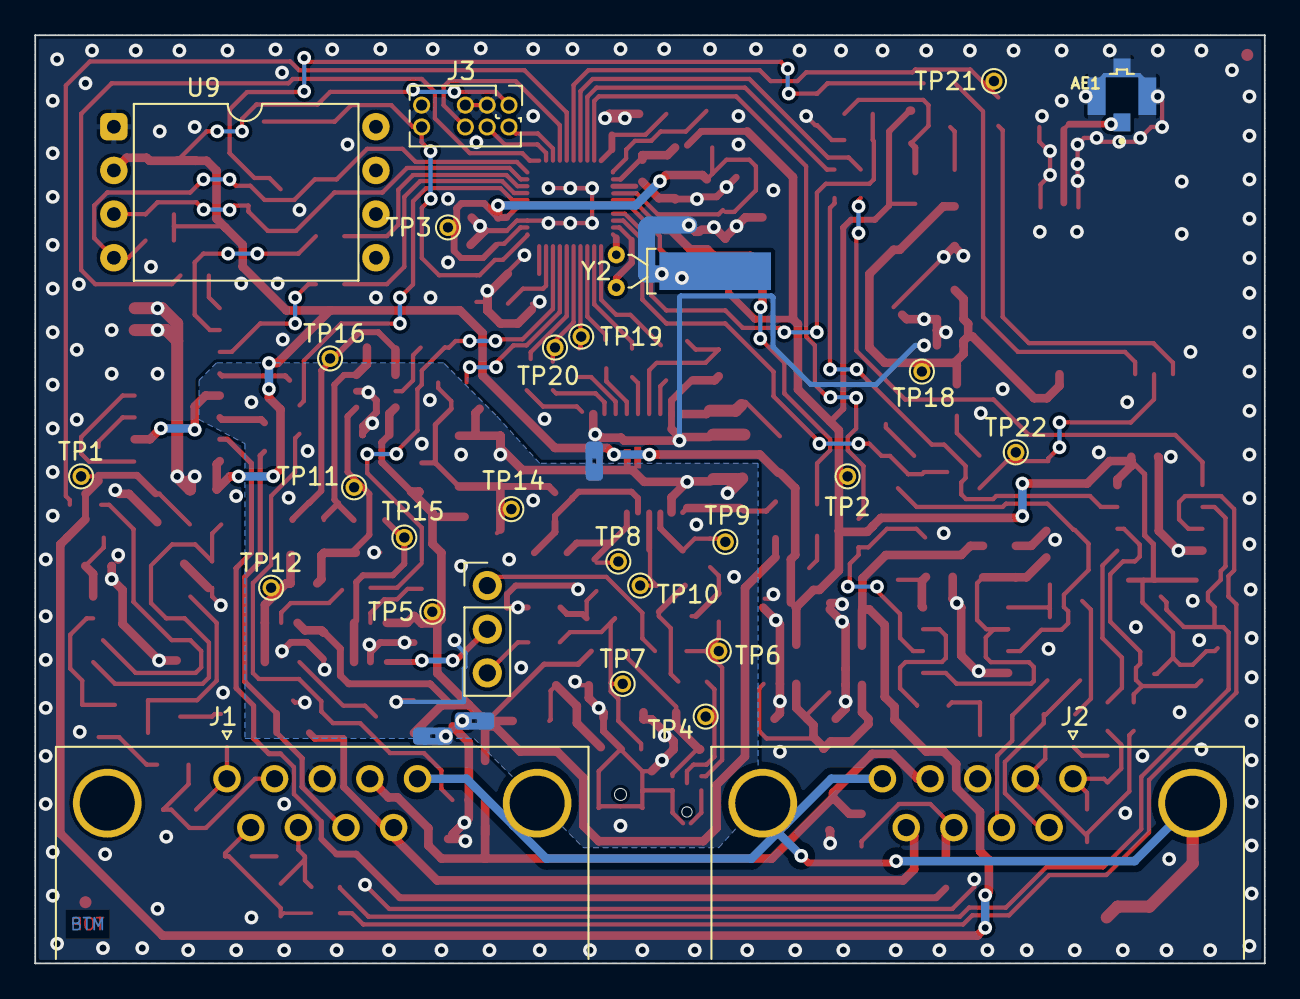
[picture p21: board SOS_Mic.kicad_pcb from below]

Board: 2 copper layers, 71.5 x 54.0 mm, 203 parts (30 on the bottom side), 130 nets.
