githupsuser/SOS/(notices)

Notices in the files:
HW/Main/SOS_Main_Supply.kicad_sch:
CC BY 4.0
